spotech-dev/iS300-Gauge-Cluster-Controller/Documents/2001-iS300-Reverse-Engineered-Pinout.pdf

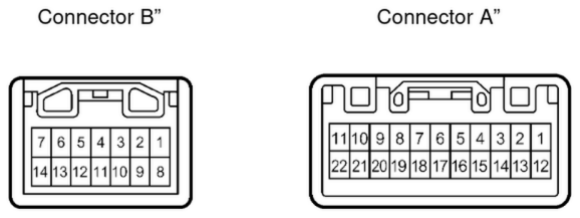
[picture p5: figure]

Pin | ESP32 GPIO | Trigger | Normally
A1 - Backlight | IO8 / GPIO8 | GND | Off
A2 - Left Signal | IO12 / GPIO12 | 12v | Off
A3 - Right Signal | IO11 / GPIO11 | 12v | Off
A5 - High Beam | IO18 / GPIO18 | GND | Off
A7 - Check Engine | IO17 / GPIO17 | GND | Off
A8 - Airbag | IO16 / GPIO16 | GND | Off
A9 - ABS | IO15 / GPIO15 | GND | On
A11 - RPM | IO10 / GPIO10 | Pulsing 12V | 0
A12 - Speed | IO7 / GPIO7 | Pulsing GND | 0
B3 - TRC OFF | IO6 / GPIO6 | GND | Off
B4 - SLIP | IO5 / GPIO5 | GND | Off
B5 - BRAKE | IO4 / GPIO4 | GND | On
B6 - Rear Lights | IO9 / GPIO9 | 12V | On
B7 - Headlight Beam Level | IO46 / GPIO46 | 12V | Off
B8 - Security | IO13 / GPIO13 | 12V | Off

Constant 12v - A4 (High Beam), A15 (MPX-B), A16, A17, A22 (Backlight) Constant GND - A18 (Signal), A19

MPX pins: A20 (MPX2), A21 (MPX1)
MPX controlled functions: Fuel, Coolant, Gear, MPG
