spotech-dev/iS300-Gauge-Cluster-Controller/PCB/BOM_iS300-Gauge-Cluster-Driver_2026-08-25.csv

ID | Name | Designator | Footprint | Quantity | Manufacturer Part | Manufacturer | Supplier | Supplier Part | Price
1 | FC-1608G1-520 | PWR | LED0603-RD | 1 | FC-1608G1-520 | 国星光电 | LCSC | C19189745 | 0.009
2 | RH-5015 | 3.3V,12V,GND | SMD_RH-5015 | 3 | RH-5015 | 荣和 | LCSC | C5199798 | 0.092
3 | BL-HJC36G-AV-TRB | IOLED1 | LED0603-R-RD_AMBER-NO_SILKSCREEN | 1 | BL-HJC36G-AV-TRB | BrtLed(佰鸿) | LCSC | C165983 | 0.023
4 | DC005_C431533 | VIN | DC-IN-TH_DC005 | 1 | DC005 | SHOU HAN(首韩) | LCSC | C431533 | 0.055
5 | 330Ω | R5 | R0805 | 1 | 0805W8F3300T5E | UNI-ROYAL(厚声) | LCSC | C17630 | 0.008
6 | PZ254V-12-22P | A | HDR-TH_22P-P2.54-V-M-R2-C11-S2.54 | 1 | PZ254V-12-22P | XFCN(兴飞) | LCSC | C492428 | 0.147
7 | PZ254V-12-14P | B | HDR-TH_14P-P2.54-V-M-R2-C7-S2.54 | 1 | PZ254V-12-14P | XFCN(兴飞) | LCSC | C492424 | 0.093
8 | TS-1088-AR02016 | BOOT,RESET | SW-SMD_L3.9-W3.0-P4.45 | 2 | TS-1088-AR02016 | XUNPU(讯普) | LCSC | C720477 | 0.056
9 | TYPE-C 16PIN 2MD(073) | USB-C | USB-C-SMD_TYPE-C-6PIN-2MD-073 | 1 | TYPE-C 16PIN 2MD(073) | SHOU HAN(首韩) | LCSC | C2765186 | 0.074
10 | 100nF | C8,C6,C5 | C0603 | 3 | CC0603KRX7R9BB104 | YAGEO(国巨) | LCSC | C14663 | 0.015
11 | TBD62783AFNG(Z,EL) | U3 | SSOP-18_L6.8-W4.4-P0.65-LS6.4-BL | 1 | TBD62783AFNG(Z,EL) | TOSHIBA(东芝) | LCSC | C4153829 | 0.753
12 | ULN2803A_C845537 | U2 | SOP-18_L11.4-W7.6-P1.27-LS10.6-BL | 1 | ULN2803A | UMW(友台半导体) | LCSC | C845537 | 0.209
13 | TPS62162DSG | U1 | WSON-8_L2.0-W2.0-P0.50-TL-EP | 1 | TPS62162DSGR | TI(德州仪器) | LCSC | C40256 | 1.218
14 | 5.1kΩ | R31,R3 | R0402 | 2 | 0402WGF5101TCE | UNI-ROYAL(厚声) | LCSC | C25905 | 0.004
15 | 100Ω | R6 | R0805 | 1 | 0805W8F1000T5E | UNI-ROYAL(厚声) | LCSC | C17408 | 0.005
16 | 10kΩ | R4,R2,R1 | R0402 | 3 | FRC0402F1002TS | FOJAN(富捷) | LCSC | C2906861 | 0.003
17 | AO3400A_C347475 | Q1 | SOT-23-3_L2.9-W1.3-P1.90-LS2.4-BR | 1 | AO3400A | UMW(友台半导体) | LCSC | C347475 | 0.037
18 | 2.2uH | L1 | L0603 | 1 | CMI160808U2R2KT | FH(风华) | LCSC | C284875 | 0.025
19 | 1812L300/16GR | F3 | F1812 | 1 | 1812L300/16GR | LUTE(陆特) | LCSC | C18198349 | 0.067
20 | SMD0805-100-12 | F2 | R0805 | 1 | SMD0805-100-12 | R+O(宏嘉诚) | LCSC | C46640991 | 0.059
21 | MF-PSMF050X-2 | F1 | F0805 | 1 | MF-PSMF050X-2 | BOURNS | LCSC | C116170 | 0.058
22 | ESP32-S3-WROOM-1(N16R8) | ESP32-S3-WROOM-1 | WIRELM-SMD_ESP32-S3-WROOM-1 | 1 | ESP32-S3-WROOM-1-N16R8 | ESPRESSIF(乐鑫) | LCSC | C2913202 | 5.181
23 | SS14 | D2 | SMA_L4.2-W2.6-LS5.0-RD_1 | 1 | SS14 | MDD(辰达半导体) | LCSC | C2480 | 0.019
24 | 100uF | C7 | CAP-SMD_BD6.3-L6.6-W6.6-LS7.2-FD | 1 | RVT100UF16V67RV0016 | KNSCHA(科尼盛) | LCSC | C2887276 | 0.031
25 | 10uF | C4,C3 | C0402 | 2 | CL05A106MQ5NUNC | SAMSUNG(三星) | LCSC | C15525 | 0.026
26 | 22uF | C2 | C0603 | 1 | CL10A226MQ8NRNC | SAMSUNG(三星) | LCSC | C59461 | 0.031
27 | 1uF | C1 | C0402 | 1 | CL05A105KA5NQNC | SAMSUNG(三星) | LCSC | C52923 | 0.012
