spotech-dev/iS300-Gauge-Cluster-Controller/(list of files, drawings)

Other design files:
PCB/EasyEDA-iS300-Controller-Layout.json
PCB/EasyEDA-iS300-Controller-Schematic.json
